supercrazylash/SkidProject/graficos-tabelas-info/tabela-de-preços.MD

| Material | Preço unitário | QTY | Total | Fonte |
| -----: | :----- | :----- | :---- | :---- |
| barras de latão | €2.71 | 2 | €5.42 | https://lingold.pt/chapa-latao/tiras-de-chapa-em-latao-15-mm |
| imanes neodinio | €8.91 | 2 | €17.82 | https://www.supermagnete.pt/screw-on-magnets/block-magnet-80-x-20-x-4mm_CS-Q-80-20-04-N?group=blocks |
| ESC (Controlador BLDC) | €26.90 | 3 | €80.70 | https://entretem.pt/variadores-esc-bec/326-speed-controller-helicopter-30a.html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 |
| Motor DC Sem Escovas (BLDC) | €9.00 | 3 | €27.00 | https://entretem.pt/motores-electricos/15556-motor-brushlessccw2204-2300kv-280mm-un.html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 |
| Bateria LiPo | €15.00 | 1 | €15.00 | https://entretem.pt/baterias/8948-Bateria-lipo-74v-1200mAh.html?search_query=++Bateria+3S&results=769 |
| Relés automóveis | €2.45 | 2 | €4.90 | https://mauser.pt/catalog/product_info.php?products_id=083-0048 |
| N-MOS | €1.72 | 2 | €3.44 | https://mauser.pt/catalog/product_info.php?products_id=002-0729 |
| Giroscopio | €10.48 | 1 | €10.48 | https://www.digikey.pt/en/products/detail/stmicroelectronics/I3G4250DTR/5268011
| Raspberry Pi Compute Module 4 8GB RAM 32GB EMMC | €105.80 | 1 | €105.80 | reaproveitado de outro projeto |
| PCBs várias (estimativa) | N/A | N/A | €35.00 (estimado) | https://aisler.net |
| Miscelanios (cabos, conversores de tensão, pin headers, etc.) | N/A | N/A | €50.00 (estimado) | vários |
| TOTAL | - | - | €355.56 | - |
