supercrazylash/SkidProject/DONTREADME.MD

# TESTE
HEAD
Linhas que estão atoa
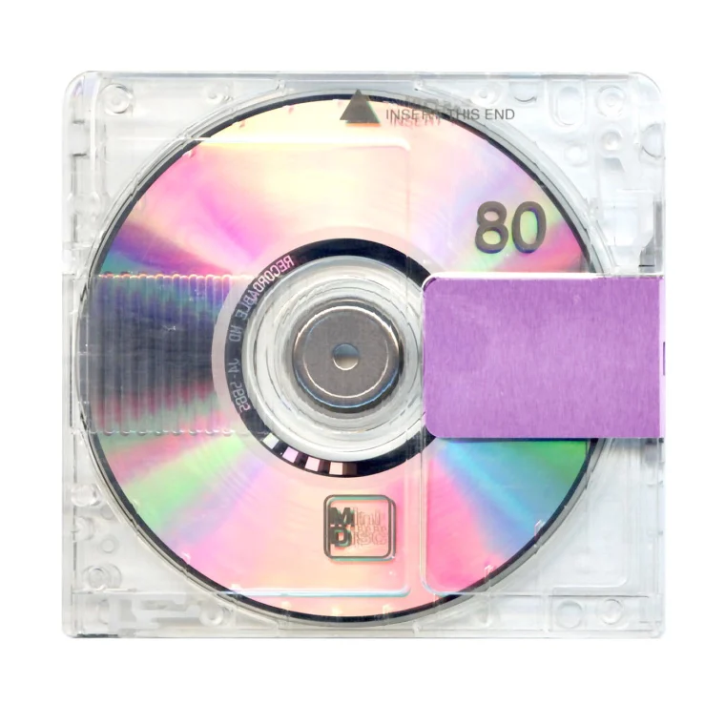
[picture p4: IMG_0239.PNG]
a


a vida é estramha

pila
