supercrazylash/SkidProject/Diagramas de Circuito/Main System/Main System.kicad_pcb

## KiCad design Diagramas de Circuito/Main System/Main System.kicad_pcb (2025-02-24)

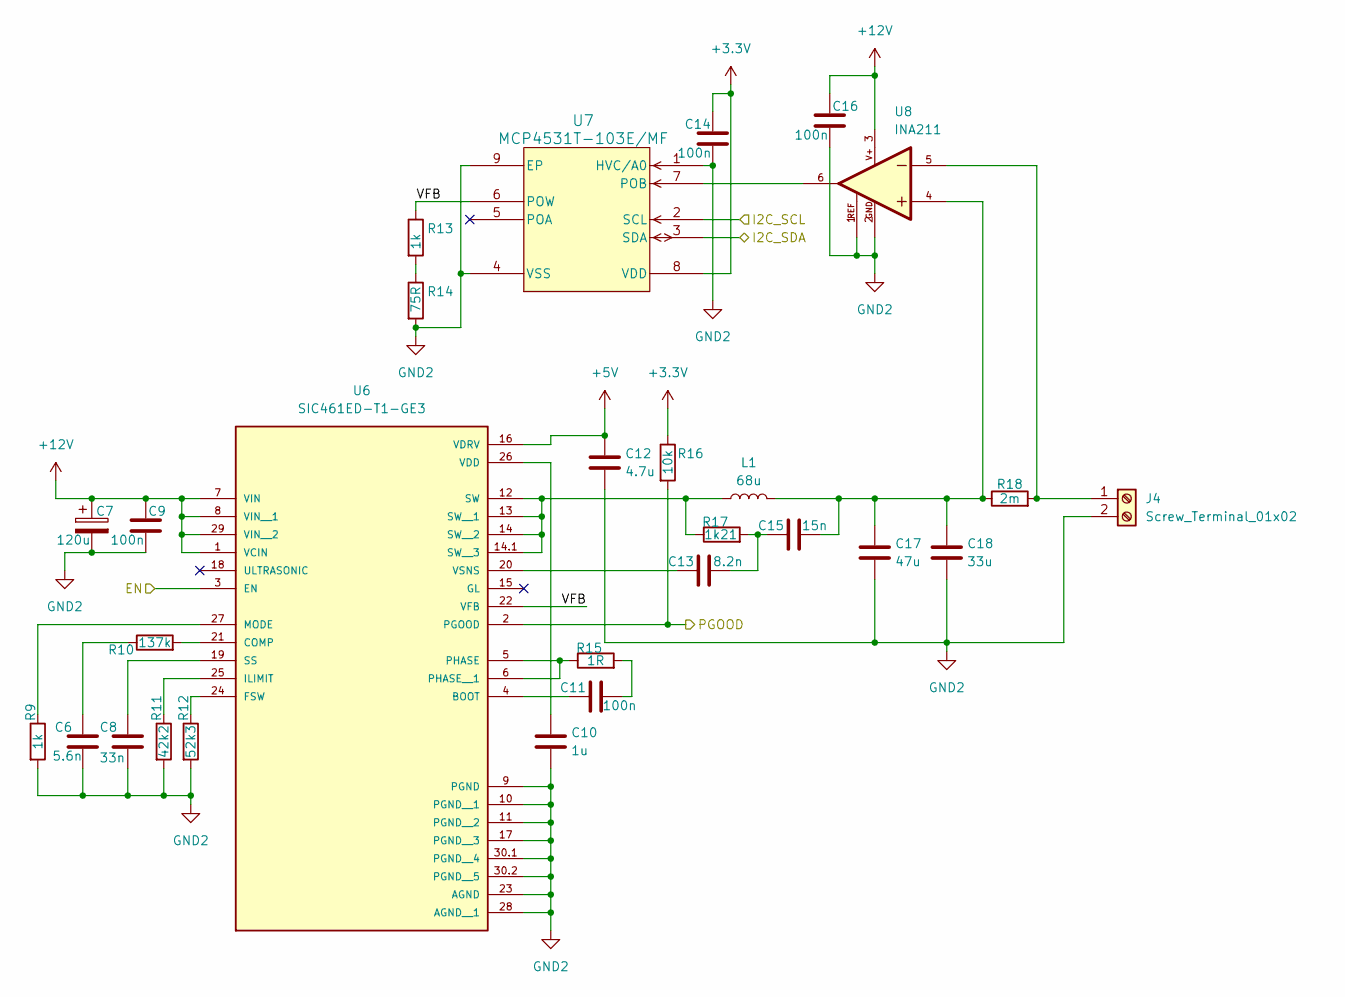
[picture p5: schematic MHD.kicad_sch]

Parts:
C6: 5.6n; C_0402_1005Metric; DIGIKEY_PN 311-3773-1-ND
C7: 120u; CP_Radial_D10.0mm_P5.00mm; DIGIKEY_PN 732-11923-1-ND
C8: 33n; C_0402_1005Metric; DIGIKEY_PN 13-CC0402JRX7R9BB333CT-ND
C9, C11, C14, C16: 100n; C_0603_1608Metric; DIGIKEY_PN 1276-1033-1-ND
C10: 1u; C_0805_2012Metric; DIGIKEY_PN 1276-1029-1-ND
C12: 4.7u; C_0603_1608Metric; DIGIKEY_PN 1276-1784-1-ND
C13: 8.2n; C_0603_1608Metric; DIGIKEY_PN 399-C0603C822K5RACTUCT-ND
C15: 15n; C_0402_1005Metric; DIGIKEY_PN 311-3813-1-ND
C17: 47u; C_1210_3225Metric; DIGIKEY_PN 490-10531-1-ND
C18: 33u; C_1206_3216Metric; DIGIKEY_PN 4713-GMC31X5R336M25NTCT-ND
J4: Screw_Terminal_01x02; TerminalBlock_Phoenix_PT-1,5-2-5.0-H_1x02_P5.00mm_Horizontal; DIGIKEY_PN 277-1667-ND
L1: 68u; L_Pulse_PA4349; DIGIKEY_PN 553-PA4349.683ANLTCT-ND
R9, R13: 1k; R_0402_1005Metric; DIGIKEY_PN P1.0KDCCT-ND
R10: 137k; R_0402_1005Metric; DIGIKEY_PN P137KLCT-ND
R11: 42k2; R_0402_1005Metric; DIGIKEY_PN 311-42.2KLRCT-ND
R12: 52k3; R_0402_1005Metric; DIGIKEY_PN P52.3KLCT-ND
R14: 75R; R_0402_1005Metric; DIGIKEY_PN P75.0LCT-ND
R15: 1R; R_0603_1608Metric; DIGIKEY_PN 311-1.00HRCT-ND
R16: 10k; R_0603_1608Metric; DIGIKEY_PN RMCF0603JT10K0CT-ND
R17: 1k21; R_0402_1005Metric; DIGIKEY_PN P1.21KLCT-ND
R18: 2m; R_2512_6332Metric; DIGIKEY_PN 13-PA2512DKF7W0R002ECT-ND
U6: SIC461ED-T1-GE3; CONV_SIC461ED-T1-GE3; PARTREV M; DIGIKEY_PN SIC461ED-T1-GE3CT-ND
U7: MCP4531T-103E/MF; DFN-8-1EP_3x3mm_P0.5mm_EP1.65x2.38mm; DIGIKEY_PN MCP4531T-103E/MFCT-ND
U8: INA211; SOT-363_SC-70-6; PARTREV J; DIGIKEY_PN 296-41417-1-ND

Connections:
+3.3V: C14.1, R16.1, U7.8 (VDD); also elsewhere on the board
+5V: C12.1, U6.16 (VDRV); also elsewhere on the board
+12V: C7.1, C9.1, C16.1, U6.1 (VCIN), U6.7 (VIN), U6.8 (VIN__1), U6.29 (VIN__2), U8.3; also elsewhere on the board
/Magneto-Hidrodynamic Drive/EN: U6.3 (EN); also elsewhere on the board
/Magneto-Hidrodynamic Drive/PGOOD: R16.2, U6.2 (PGOOD); also elsewhere on the board
/Magneto-Hidrodynamic Drive/VFB: R13.1, U6.22 (VFB), U7.6 (POW)
/Processor/I2C_SCL: U7.2 (SCL); also elsewhere on the board
/Processor/I2C_SDA: U7.3 (SDA); also elsewhere on the board
GND2: C6.2, C7.2, C8.2, C9.2, C10.2, C12.2, C14.2, C16.2, C17.2, C18.2, J4.2, R9.2, R11.2, R12.2, R14.2, U6.9 (PGND), U6.10 (PGND__1), U6.11 (PGND__2), U6.17 (PGND__3), U6.23 (AGND), U6.28 (AGND__1), U6.30.1 (PGND__4), U6.30.2 (PGND__5), U7.1 (HVC/A0), U7.4 (VSS), U7.9 (EP), U8.1, U8.2; also elsewhere on the board
unnamed: C6.1, R10.1
unnamed: C11.2, R15.2
unnamed: C13.2, C15.1, R17.2
unnamed: C15.2, C17.1, C18.1, L1.2, R18.1, U8.4
unnamed: J4.1, R18.2, U8.5
unnamed: R13.2, R14.1
unnamed: C11.1, U6.4 (BOOT)
unnamed: R10.2, U6.21 (COMP)
unnamed: R12.1, U6.24 (FSW)
unnamed: R11.1, U6.25 (ILIMIT)
unnamed: R9.1, U6.27 (MODE)
unnamed: R15.1, U6.5 (PHASE), U6.6 (PHASE__1)
unnamed: C8.1, U6.19 (SS)
unnamed: L1.1, R17.1, U6.12 (SW), U6.13 (SW__1), U6.14 (SW__2), U6.14.1 (SW__3)
unnamed: C10.1, U6.26 (VDD)
unnamed: C13.1, U6.20 (VSNS)
unnamed: U7.7 (POB), U8.6

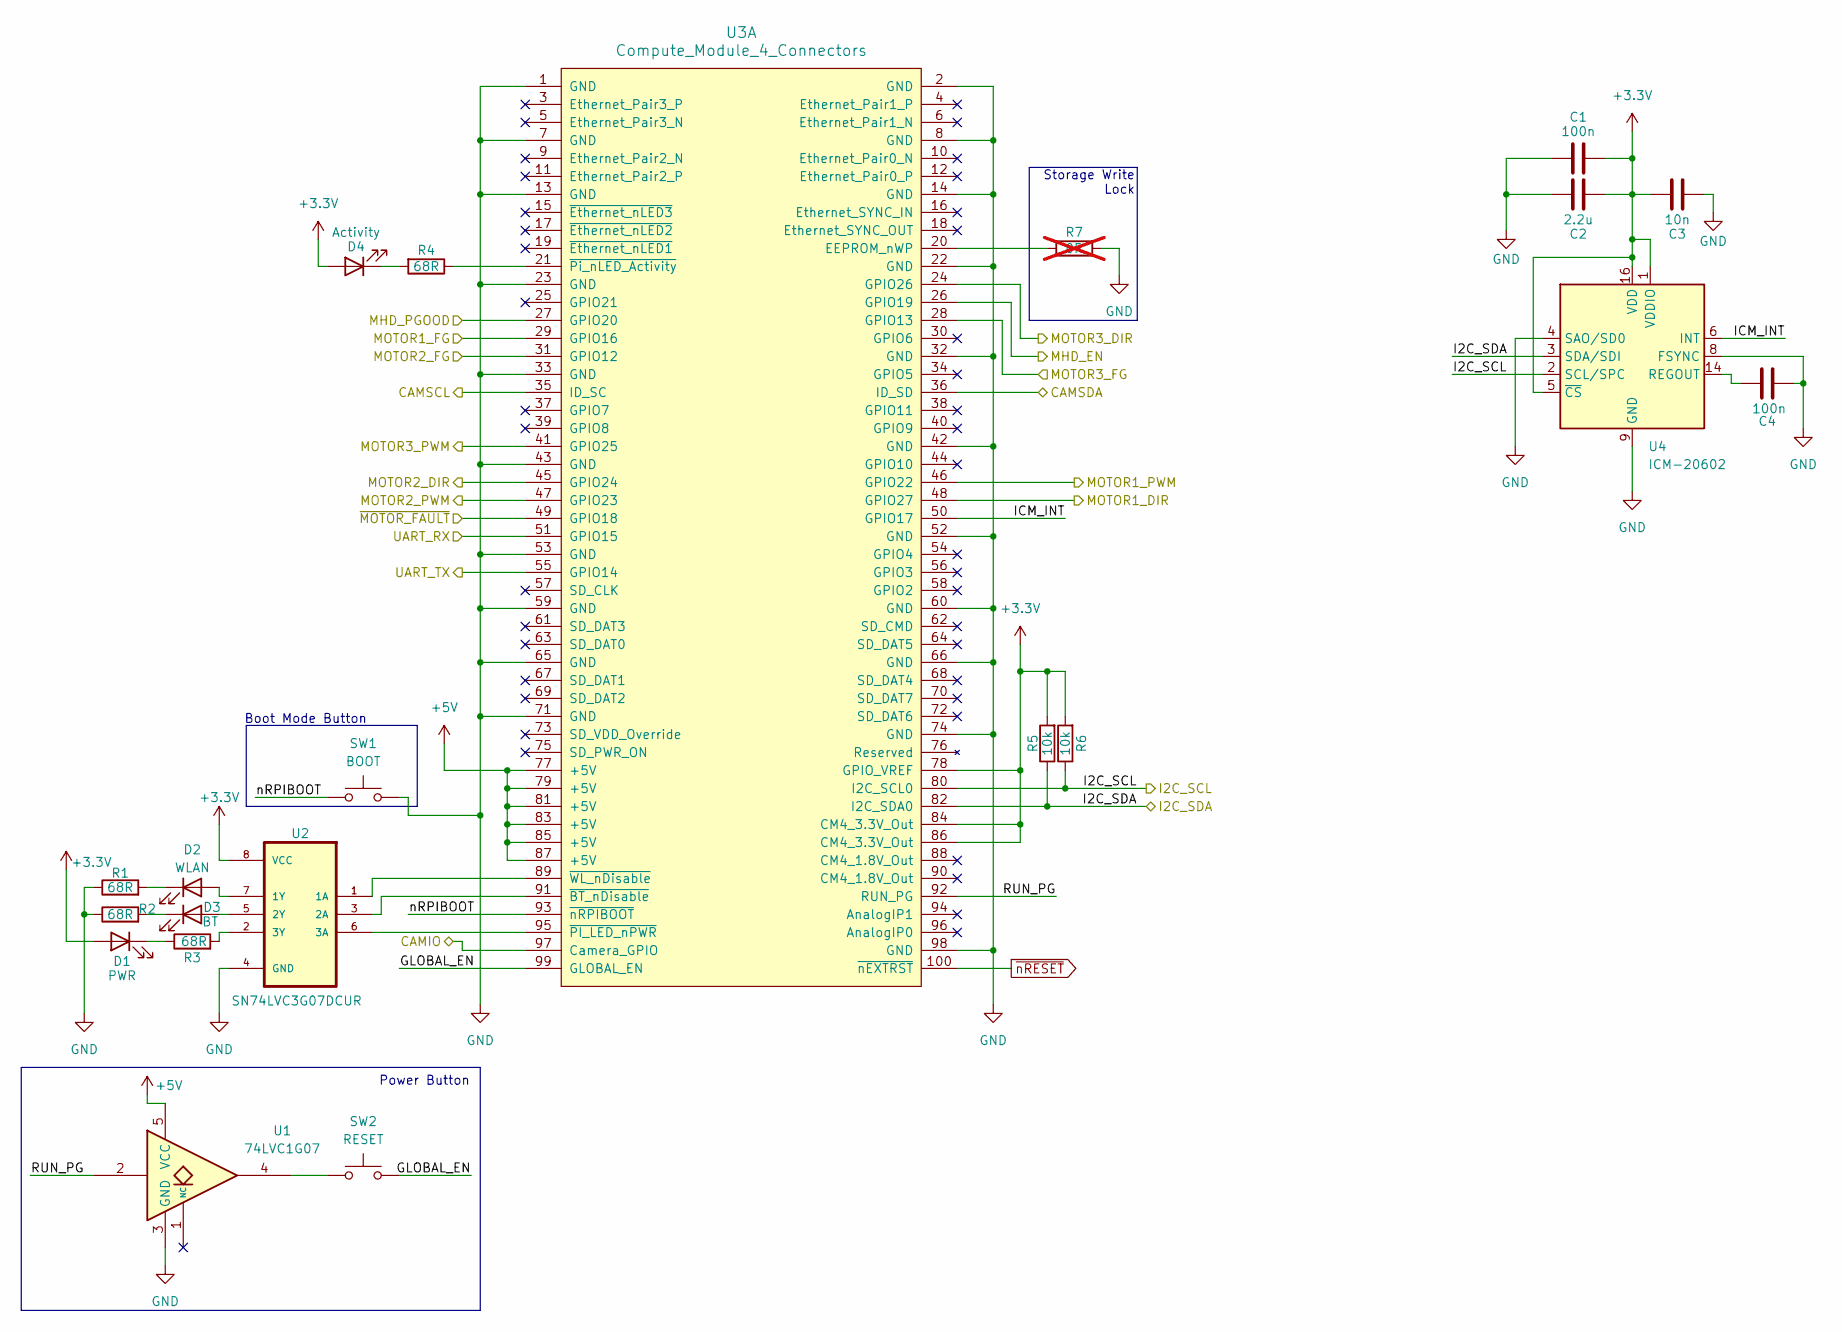
[picture p6: schematic Processor.kicad_sch]

Parts:
C1, C4: 100n; C_0603_1608Metric; DIGIKEY_PN 1276-1033-1-ND
C2: 2.2u; C_0603_1608Metric; DIGIKEY_PN 1276-1040-1-ND
C3: 10n; C_0402_1005Metric; DIGIKEY_PN 1276-1028-1-ND
D1: PWR; LED_0603_1608Metric; DIGIKEY_PN 732-4978-1-ND
D2: WLAN; LED_0603_1608Metric; DIGIKEY_PN 732-4980-1-ND
D3: BT; LED_0603_1608Metric; DIGIKEY_PN 732-4980-1-ND
D4: Activity; LED_0603_1608Metric; DIGIKEY_PN 732-4980-1-ND
R1, R2, R3, R4: 68R; R_0402_1005Metric; DIGIKEY_PN P68.0LCT-ND
R5, R6: 10k; R_0603_1608Metric; DIGIKEY_PN RMCF0603JT10K0CT-ND
R7: 0R; R_0402_1005Metric; DIGIKEY_PN P0.0JCT-ND; not fitted
SW1: BOOT; SW_SPST_PTS647_Sx38; DIGIKEY_PN PTS647SM38SMTR2LFSCT-ND
SW2: RESET; SW_SPST_PTS647_Sx38; DIGIKEY_PN PTS647SM38SMTR2LFSCT-ND
U1: 74LVC1G07; SOT-23-5; DIGIKEY_PN 296-8485-1-ND
U2: SN74LVC3G07DCUR; VSSOP-8_2.3x2mm_P0.5mm; DIGIKEY_PN 296-13283-1-ND
U3: Compute_Module_4_Connectors; Raspberry-Pi-4-Compute-Module; DIGIKEY_PN H11615CT-ND
U4: ICM-20602; LGA-16_3x3mm_P0.5mm_LayoutBorder3x5y; DIGIKEY_PN 1428-1060-1-ND

Connections:
+3.3V: C1.2, C2.2, C3.1, D1.2 (A), D4.2 (A), R5.2, R6.2, U2.8 (VCC), U3.78 (GPIO_VREF), U3.84 (CM4_3.3V_Out), U3.86 (CM4_3.3V_Out), U4.1 (VDDIO), U4.5 (~CS), U4.16 (VDD); also elsewhere on the board
+5V: U1.5 (VCC), U3.77 (+5V), U3.79 (+5V), U3.81 (+5V), U3.83 (+5V), U3.85 (+5V), U3.87 (+5V); also elsewhere on the board
/High Speed IO/CAMIO: U3.97 (Camera_GPIO); also elsewhere on the board
/High Speed IO/CAMSCL: U3.35 (ID_SC); also elsewhere on the board
/High Speed IO/CAMSDA: U3.36 (ID_SD); also elsewhere on the board
/High Speed IO/UART_RX: U3.55 (GPIO14); also elsewhere on the board
/High Speed IO/UART_TX: U3.51 (GPIO15); also elsewhere on the board
/Magneto-Hidrodynamic Drive/EN: U3.26 (GPIO19); also elsewhere on the board
/Magneto-Hidrodynamic Drive/PGOOD: U3.27 (GPIO20); also elsewhere on the board
/Processor/GLOBAL_EN: SW2.2, U3.99 (GLOBAL_EN)
/Processor/I2C_SCL: R6.1, U3.80 (I2C_SCL0), U4.2 (SCL/SPC); also elsewhere on the board
/Processor/I2C_SDA: R5.1, U3.82 (I2C_SDA0), U4.3 (SDA/SDI); also elsewhere on the board
/Processor/ICM_INT: U3.50 (GPIO17), U4.6 (INT)
/Processor/MOTOR1_DIR: U3.48 (GPIO27); also elsewhere on the board
/Processor/MOTOR1_FG: U3.29 (GPIO16); also elsewhere on the board
/Processor/MOTOR1_PWM: U3.46 (GPIO22); also elsewhere on the board
/Processor/MOTOR2_DIR: U3.45 (GPIO24); also elsewhere on the board
/Processor/MOTOR2_FG: U3.31 (GPIO12); also elsewhere on the board
/Processor/MOTOR2_PWM: U3.47 (GPIO23); also elsewhere on the board
/Processor/MOTOR3_DIR: U3.24 (GPIO26); also elsewhere on the board
/Processor/MOTOR3_FG: U3.28 (GPIO13); also elsewhere on the board
/Processor/MOTOR3_PWM: U3.41 (GPIO25); also elsewhere on the board
/Processor/RUN_PG: U1.2, U3.92 (RUN_PG)
/Processor/nRPIBOOT: SW1.1, U3.93 (~nRPIBOOT)
/Processor/~MOTOR_FAULT: U3.49 (GPIO18); also elsewhere on the board
GND: C1.1, C2.1, C3.2, C4.2, R1.1, R2.1, R7.2, SW1.2, U1.3 (GND), U2.4 (GND), U3.1 (GND), U3.2 (GND), U3.7 (GND), U3.8 (GND), U3.13 (GND), U3.14 (GND), U3.22 (GND), U3.23 (GND), U3.32 (GND), U3.33 (GND), U3.42 (GND), U3.43 (GND), U3.52 (GND), U3.53 (GND), U3.59 (GND), U3.60 (GND), U3.65 (GND), U3.66 (GND), U3.71 (GND), U3.74 (GND), U3.98 (GND), U4.4 (SAO/SD0), U4.8 (FSYNC), U4.9 (GND), U4.10 (GND), U4.11 (GND), U4.12 (GND), U4.13 (GND), U4.15 (GND); also elsewhere on the board
unnamed: D1.1 (K), R3.1
unnamed: D2.2 (A), U2.7 (1Y)
unnamed: D2.1 (K), R1.2
unnamed: D3.2 (A), U2.5 (2Y)
unnamed: D3.1 (K), R2.2
unnamed: D4.1 (K), R4.2
unnamed: SW2.1, U1.4
unnamed: U2.1 (1A), U3.89 (~WL_nDisable)
unnamed: U2.3 (2A), U3.91 (~BT_nDisable)
unnamed: U2.6 (3A), U3.95 (~PI_LED_nPWR)
unnamed: R3.2, U2.2 (3Y)
unnamed: R7.1, U3.20 (EEPROM_nWP)
unnamed: R4.1, U3.21 (~Pi_nLED_Activity)
unnamed: C4.1, U4.14 (REGOUT)
~nRESET: U3.100 (~nEXTRST); also elsewhere on the board

Notes on the sheet:
Storage Write Lock
Power Button
Boot Mode Button

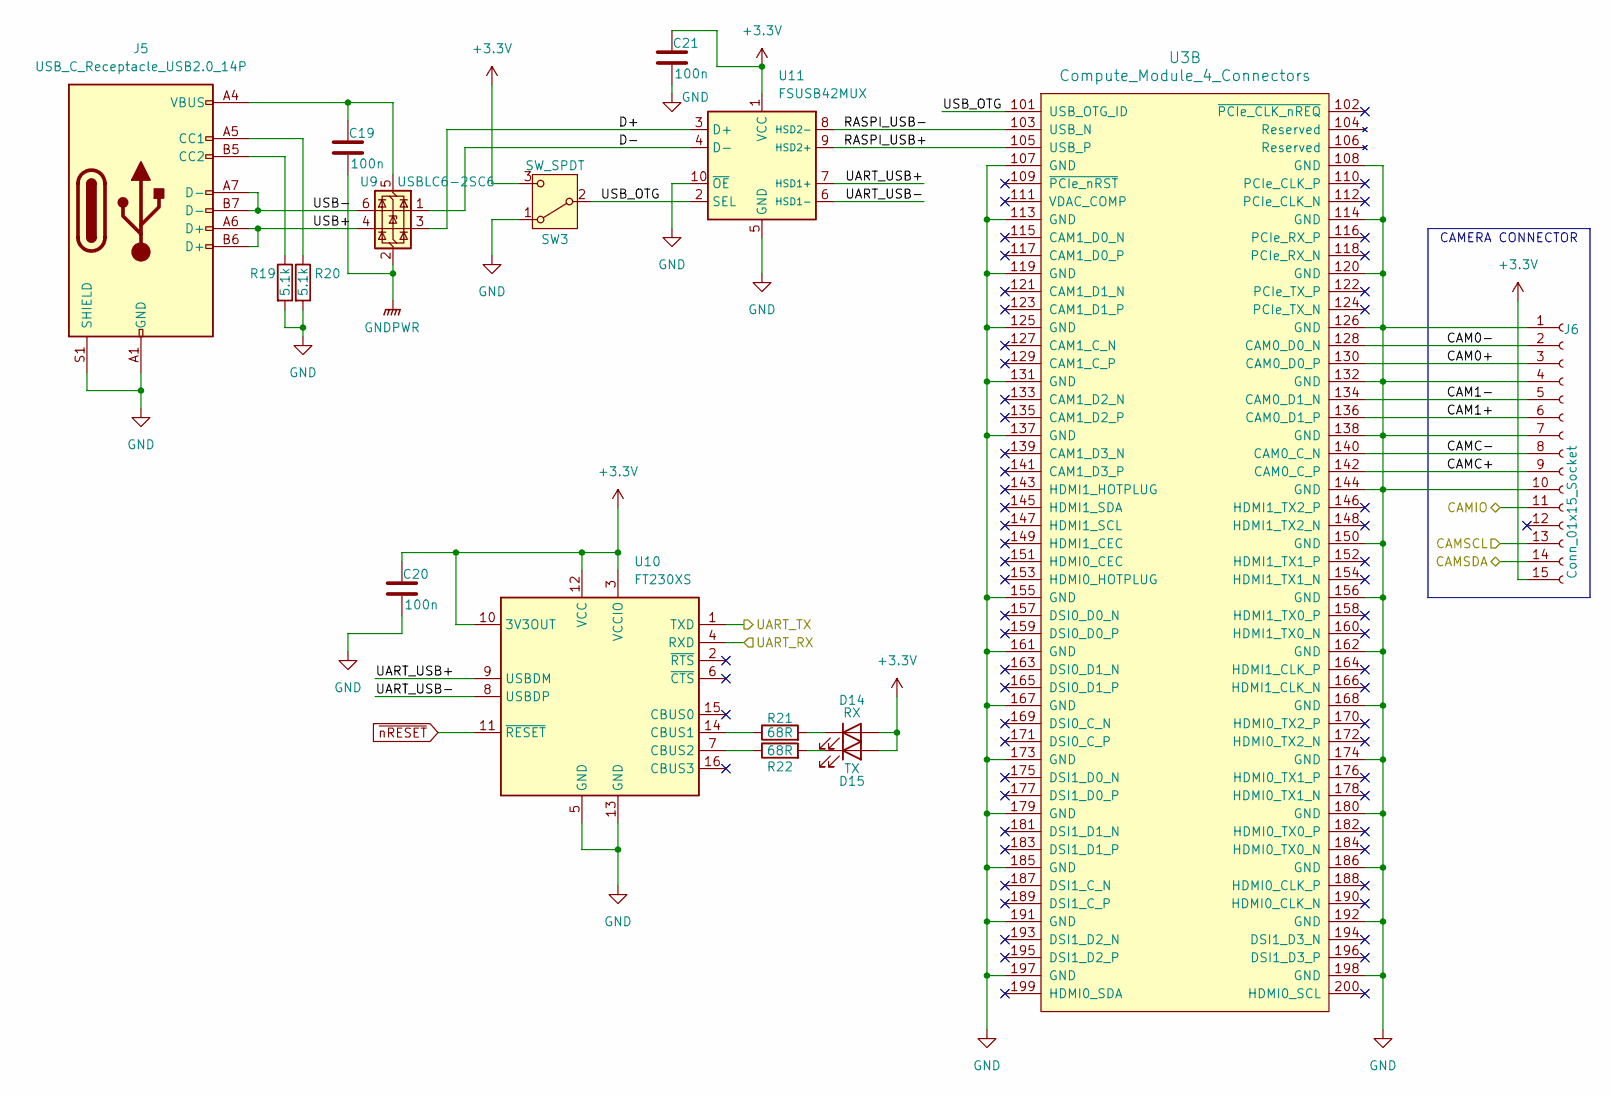
[picture p7: schematic HSIO.kicad_sch]

Parts:
C19, C20, C21: 100n; C_0603_1608Metric; DIGIKEY_PN 1276-1033-1-ND
D14: RX; LED_0603_1608Metric; DIGIKEY_PN 732-4980-1-ND
D15: TX; LED_0603_1608Metric; DIGIKEY_PN 732-4980-1-ND
J5: USB_C_Receptacle_USB2.0_14P; USB4120-03-C_GCT; DIGIKEY_PN 2073-USB4120-03-CCT-ND
J6: Conn_01x15_Socket; GCT_FFC3A20-15-G_REVA1; DIGIKEY_PN 2073-FFC3A20-15-GCT-ND
R19, R20: 5.1k; R_0402_1005Metric; DIGIKEY_PN P5.10KLCT-ND
R21, R22: 68R; R_0402_1005Metric; DIGIKEY_PN P68.0LCT-ND
SW3: SW_SPDT; SW_JS102011JCQN; DIGIKEY_PN CKN10721CT-ND
U3: Compute_Module_4_Connectors; Raspberry-Pi-4-Compute-Module; DIGIKEY_PN H11615CT-ND
U9: USBLC6-2SC6; SOT-23-6; DIGIKEY_PN 497-5235-1-ND
U10: FT230XS; SSOP-16_3.9x4.9mm_P0.635mm; DIGIKEY_PN 768-1135-1-ND
U11: FSUSB42MUX; MSOP-10_3x3mm_P0.5mm; DIGIKEY_PN FSUSB42MUXCT-ND

Connections:
+3.3V: C20.1, C21.1, D14.2 (A), D15.2 (A), J6.15, SW3.3 (C), U10.3 (VCCIO), U10.10 (3V3OUT), U10.12 (VCC), U11.1 (VCC); also elsewhere on the board
/High Speed IO/CAM0+: J6.3, U3.130 (CAM0_D0_P)
/High Speed IO/CAM0-: J6.2, U3.128 (CAM0_D0_N)
/High Speed IO/CAM1+: J6.6, U3.136 (CAM0_D1_P)
/High Speed IO/CAM1-: J6.5, U3.134 (CAM0_D1_N)
/High Speed IO/CAMC+: J6.9, U3.142 (CAM0_C_P)
/High Speed IO/CAMC-: J6.8, U3.140 (CAM0_C_N)
/High Speed IO/CAMIO: J6.11; also elsewhere on the board
/High Speed IO/CAMSCL: J6.13; also elsewhere on the board
/High Speed IO/CAMSDA: J6.14; also elsewhere on the board
/High Speed IO/D+: U9.3 (I/O2), U11.3 (D+)
/High Speed IO/D-: U9.1 (I/O1), U11.4 (D-)
/High Speed IO/RASPI_USB+: U3.105 (USB_P), U11.9 (HSD2+)
/High Speed IO/RASPI_USB-: U3.103 (USB_N), U11.8 (HSD2-)
/High Speed IO/UART_RX: U10.4 (RXD); also elsewhere on the board
/High Speed IO/UART_TX: U10.1 (TXD); also elsewhere on the board
/High Speed IO/UART_USB+: U10.9 (USBDM), U11.7 (HSD1+)
/High Speed IO/UART_USB-: U10.8 (USBDP), U11.6 (HSD1-)
/High Speed IO/USB+: J5.A6 (D+), J5.B6 (D+), U9.4 (I/O2)
/High Speed IO/USB-: J5.A7 (D-), J5.B7 (D-), U9.6 (I/O1)
/High Speed IO/USB_OTG: SW3.2 (B), U3.101 (USB_OTG_ID), U11.2 (SEL)
GND: C20.2, C21.2, J5.A1 (GND), J5.A12 (GND), J5.B1 (GND), J5.B12 (GND), J5.S1 (SHIELD), J6.1, J6.4, J6.7, J6.10, R19.2, R20.2, SW3.1 (A), U3.107 (GND), U3.108 (GND), U3.113 (GND), U3.114 (GND), U3.119 (GND), U3.120 (GND), U3.125 (GND), U3.126 (GND), U3.131 (GND), U3.132 (GND), U3.137 (GND), U3.138 (GND), U3.144 (GND), U3.150 (GND), U3.155 (GND), U3.156 (GND), U3.161 (GND), U3.162 (GND), U3.167 (GND), U3.168 (GND), U3.173 (GND), U3.174 (GND), U3.179 (GND), U3.180 (GND), U3.185 (GND), U3.186 (GND), U3.191 (GND), U3.192 (GND), U3.197 (GND), U3.198 (GND), U10.5 (GND), U10.13 (GND), U11.5 (GND), U11.10 (~OE); also elsewhere on the board
GNDPWR: C19.2, U9.2 (GND); also elsewhere on the board
unnamed: D14.1 (K), R21.2
unnamed: D15.1 (K), R22.2
unnamed: J5.A5 (CC1), R20.1
unnamed: J5.B5 (CC2), R19.1
unnamed: C19.1, J5.A4 (VBUS), J5.A9 (VBUS), J5.B4 (VBUS), J5.B9 (VBUS), U9.5 (VBUS)
unnamed: R21.1, U10.14 (CBUS1)
unnamed: R22.1, U10.7 (CBUS2)
~nRESET: U10.11 (~RESET); also elsewhere on the board

Notes on the sheet:
CAMERA CONNECTOR

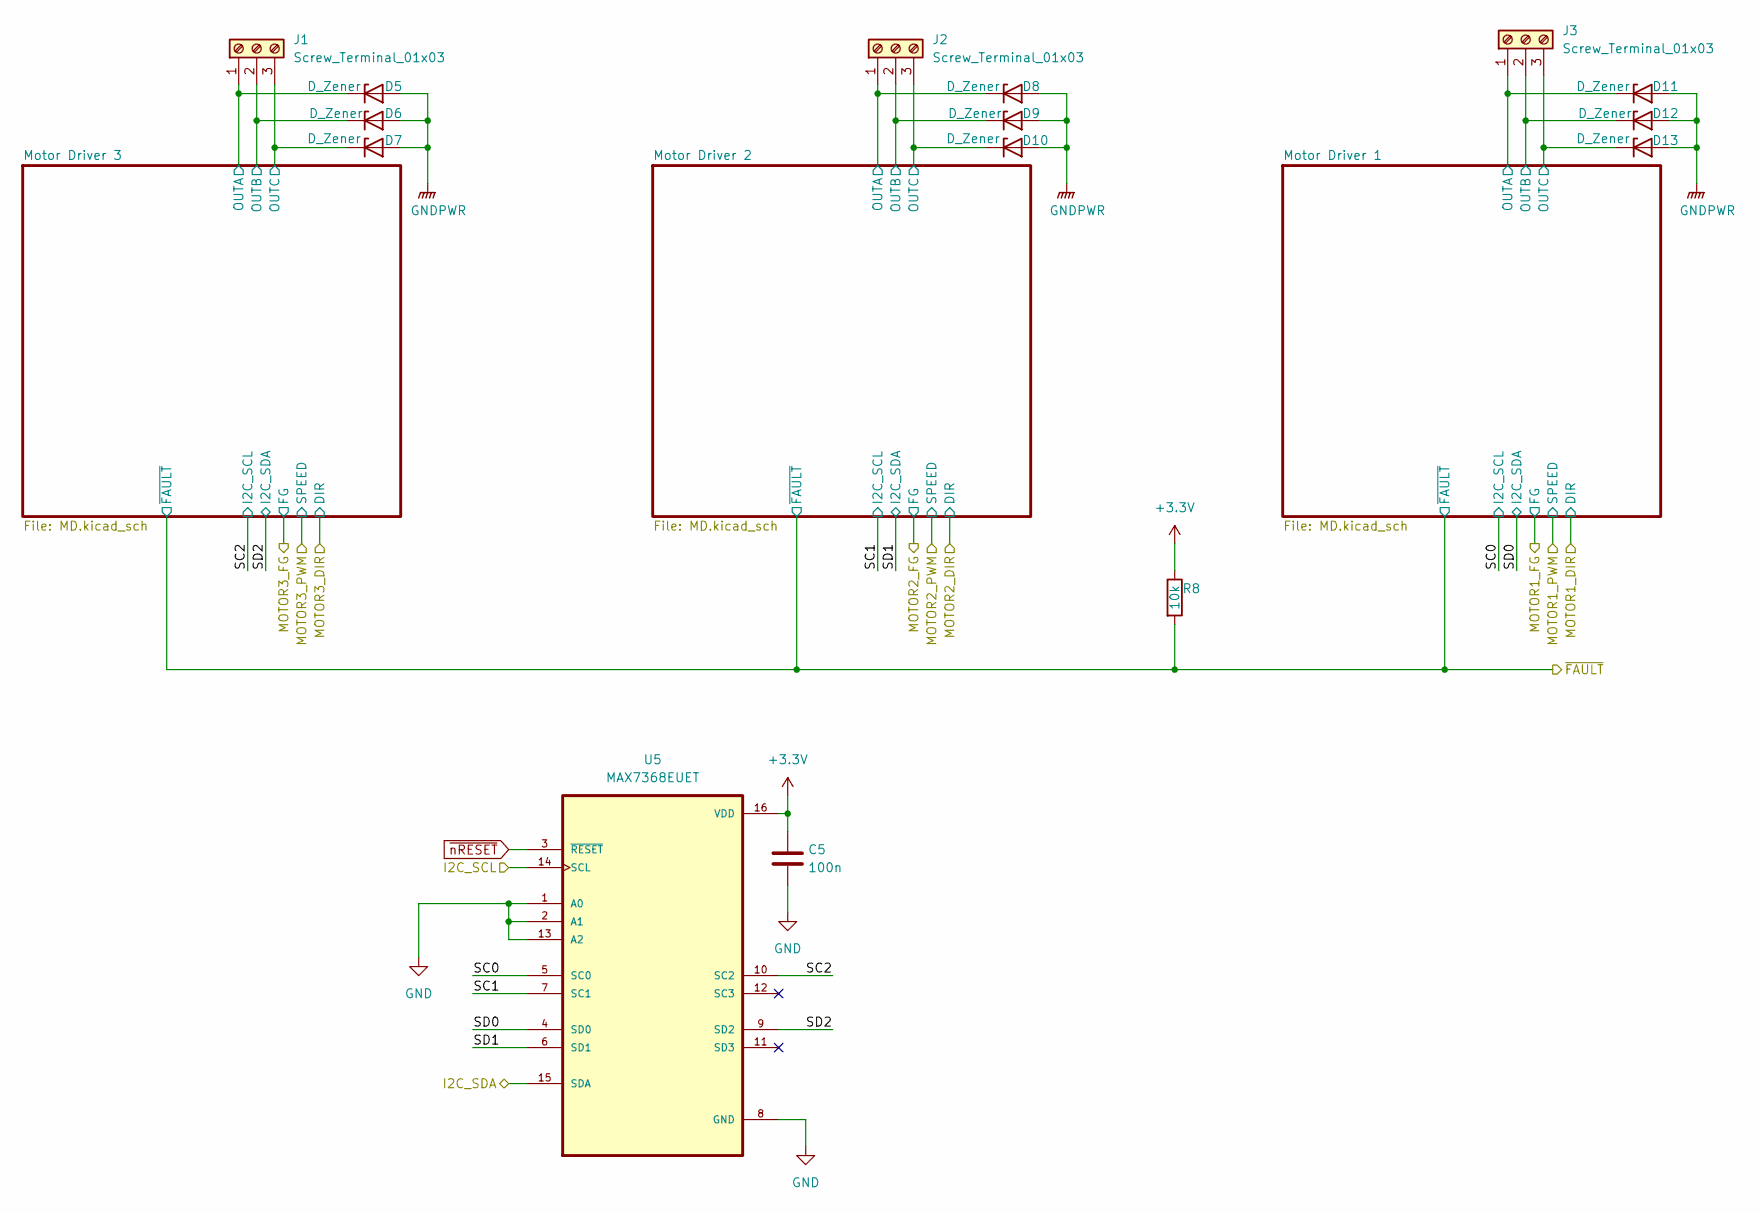
[picture p8: schematic reaction_wheels.kicad_sch]

Parts:
C5: 100n; C_0603_1608Metric; DIGIKEY_PN 1276-1033-1-ND
D5, D6, D7, D8, D9, D10, D11, D12, D13: D_Zener; D_SMB; DIGIKEY_PN SMBJ10A-FDICT-ND
J1, J2, J3: Screw_Terminal_01x03; TerminalBlock_Phoenix_PT-1,5-3-5.0-H_1x03_P5.00mm_Horizontal; DIGIKEY_PN 277-1578-ND
R8: 10k; R_0603_1608Metric; DIGIKEY_PN RMCF0603JT10K0CT-ND
U5: MAX7368EUET; TSSOP-16_4.4x5mm_P0.65mm; DIGIKEY_PN MAX7368EUE+-ND

Connections:
+3.3V: C5.1, R8.1, U5.16 (VDD); also elsewhere on the board
/Processor/I2C_SCL: U5.14 (SCL); also elsewhere on the board
/Processor/I2C_SDA: U5.15 (SDA); also elsewhere on the board
/Processor/~MOTOR_FAULT: R8.2; also elsewhere on the board
/Reaction Wheels/Motor Driver 1/OUTA: D11.1 (K), J3.1; also elsewhere on the board
/Reaction Wheels/Motor Driver 1/OUTB: D12.1 (K), J3.2; also elsewhere on the board
/Reaction Wheels/Motor Driver 1/OUTC: D13.1 (K), J3.3; also elsewhere on the board
/Reaction Wheels/Motor Driver 2/OUTA: D8.1 (K), J2.1; also elsewhere on the board
/Reaction Wheels/Motor Driver 2/OUTB: D9.1 (K), J2.2; also elsewhere on the board
/Reaction Wheels/Motor Driver 2/OUTC: D10.1 (K), J2.3; also elsewhere on the board
/Reaction Wheels/Motor Driver 3/OUTA: D5.1 (K), J1.1; also elsewhere on the board
/Reaction Wheels/Motor Driver 3/OUTB: D6.1 (K), J1.2; also elsewhere on the board
/Reaction Wheels/Motor Driver 3/OUTC: D7.1 (K), J1.3; also elsewhere on the board
/Reaction Wheels/SC0: U5.5 (SC0); also elsewhere on the board
/Reaction Wheels/SC1: U5.7 (SC1); also elsewhere on the board
/Reaction Wheels/SC2: U5.10 (SC2); also elsewhere on the board
/Reaction Wheels/SD0: U5.4 (SD0); also elsewhere on the board
/Reaction Wheels/SD1: U5.6 (SD1); also elsewhere on the board
/Reaction Wheels/SD2: U5.9 (SD2); also elsewhere on the board
GND: C5.2, U5.1 (A0), U5.2 (A1), U5.8 (GND), U5.13 (A2); also elsewhere on the board
GNDPWR: D5.2 (A), D6.2 (A), D7.2 (A), D8.2 (A), D9.2 (A), D10.2 (A), D11.2 (A), D12.2 (A), D13.2 (A); also elsewhere on the board
~nRESET: U5.3 (~RESET); also elsewhere on the board

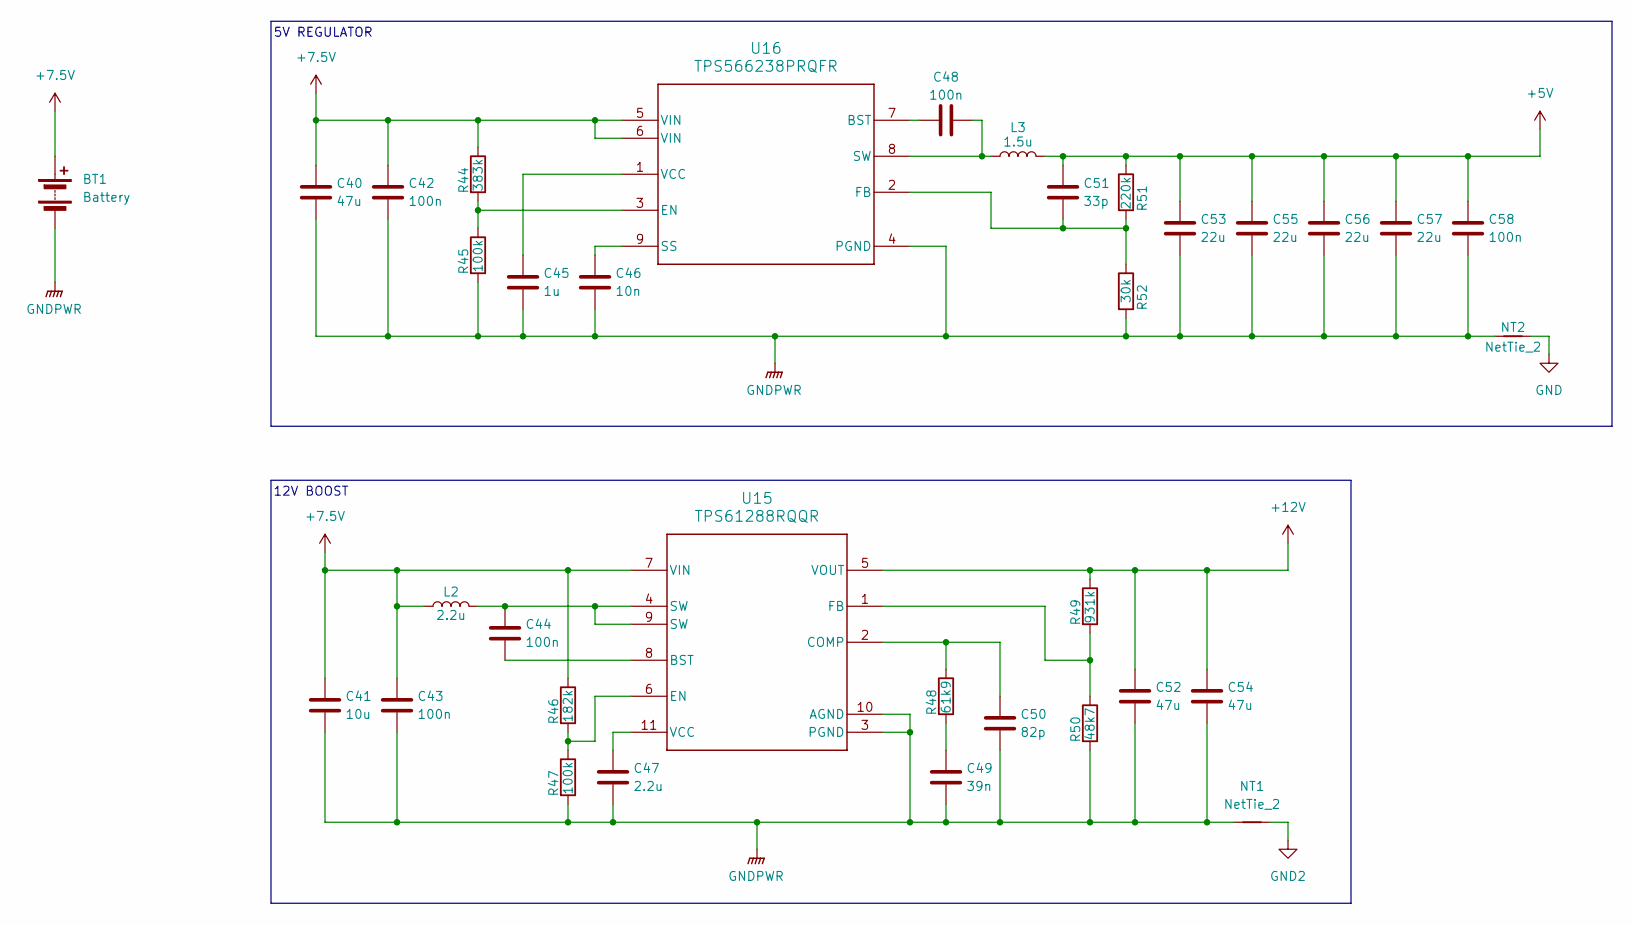
[picture p9: schematic psup.kicad_sch]

Parts:
BT1: Battery; DEANS; DIGIKEY_PN 1568-1659-ND
C40, C52, C54: 47u; C_1210_3225Metric; DIGIKEY_PN 490-10531-1-ND
C41: 10u; C_0805_2012Metric; DIGIKEY_PN 1276-6455-1-ND
C42, C43, C44, C48, C58: 100n; C_0603_1608Metric; DIGIKEY_PN 1276-1033-1-ND
C45: 1u; C_0805_2012Metric; DIGIKEY_PN 1276-1029-1-ND
C46: 10n; C_0402_1005Metric; DIGIKEY_PN 1276-1028-1-ND
C47: 2.2u; C_0603_1608Metric; DIGIKEY_PN 1276-1040-1-ND
C49: 39n; C_0603_1608Metric; DIGIKEY_PN 1276-2055-1-ND
C50: 82p; C_0402_1005Metric; DIGIKEY_PN 311-1023-1-ND
C51: 33p; C_0402_1005Metric; DIGIKEY_PN 1276-1272-1-ND
C53, C55, C56, C57: 22u; C_1206_3216Metric; DIGIKEY_PN 1276-3047-1-ND
L2: 2.2u; IND_IHLP-5050CE-01_VIS; DIGIKEY_PN 541-1019-1-ND
L3: 1.5u; IND_-1R5MC_SUM; DIGIKEY_PN 308-2497-1-ND
NT1, NT2: NetTie_2; NetTie-2_SMD_Pad2.0mm
R44: 383k; R_0402_1005Metric; DIGIKEY_PN P383KLCT-ND
R45, R47: 100k; R_0603_1608Metric; DIGIKEY_PN P100KHCT-ND
R46: 182k; R_0402_1005Metric; DIGIKEY_PN P182KLCT-ND
R48: 61k9; R_0402_1005Metric; DIGIKEY_PN P61.9KLCT-ND
R49: 931k; R_0402_1005Metric; DIGIKEY_PN P931KLCT-ND
R50: 48k7; R_0402_1005Metric; DIGIKEY_PN P48.7KLCT-ND
R51: 220k; R_0402_1005Metric; DIGIKEY_PN P220KLCT-ND
R52: 30k; R_0402_1005Metric; DIGIKEY_PN P30.0KLCT-ND
U15: TPS61288RQQR; RQQ0011A-MFG; DIGIKEY_PN 296-TPS61288RQQRCT-ND
U16: TPS566238PRQFR; RQF0009A; DIGIKEY_PN 296-TPS566238PRQFRCT-ND

Connections:
+5V: C51.1, C53.1, C55.1, C56.1, C57.1, C58.1, L3.2, R51.1; also elsewhere on the board
+7.5V: BT1.1 (+), C40.1, C41.1, C42.1, C43.1, L2.1, R44.1, R46.1, U15.7 (VIN), U16.5 (VIN), U16.6 (VIN); also elsewhere on the board
+12V: C52.1, C54.1, R49.1, U15.5 (VOUT); also elsewhere on the board
GND: NT2.2; also elsewhere on the board
GND2: NT1.2; also elsewhere on the board
GNDPWR: BT1.2 (-), C40.2, C41.2, C42.2, C43.2, C45.2, C46.2, C47.2, C49.2, C50.2, C52.2, C53.2, C54.2, C55.2, C56.2, C57.2, C58.2, NT1.1, NT2.1, R45.2, R47.2, R50.2, R52.2, U15.3 (PGND), U15.10 (AGND), U16.4 (PGND); also elsewhere on the board
unnamed: C44.1, L2.2, U15.4 (SW), U15.9 (SW)
unnamed: C49.1, R48.2
unnamed: C44.2, U15.8 (BST)
unnamed: C50.1, R48.1, U15.2 (COMP)
unnamed: R46.2, R47.1, U15.6 (EN)
unnamed: R49.2, R50.1, U15.1 (FB)
unnamed: C47.1, U15.11 (VCC)
unnamed: C48.1, U16.7 (BST)
unnamed: R44.2, R45.1, U16.3 (EN)
unnamed: C51.2, R51.2, R52.1, U16.2 (FB)
unnamed: C46.1, U16.9 (SS)
unnamed: C48.2, L3.1, U16.8 (SW)
unnamed: C45.1, U16.1 (VCC)

Notes on the sheet:
5V REGULATOR
12V BOOST

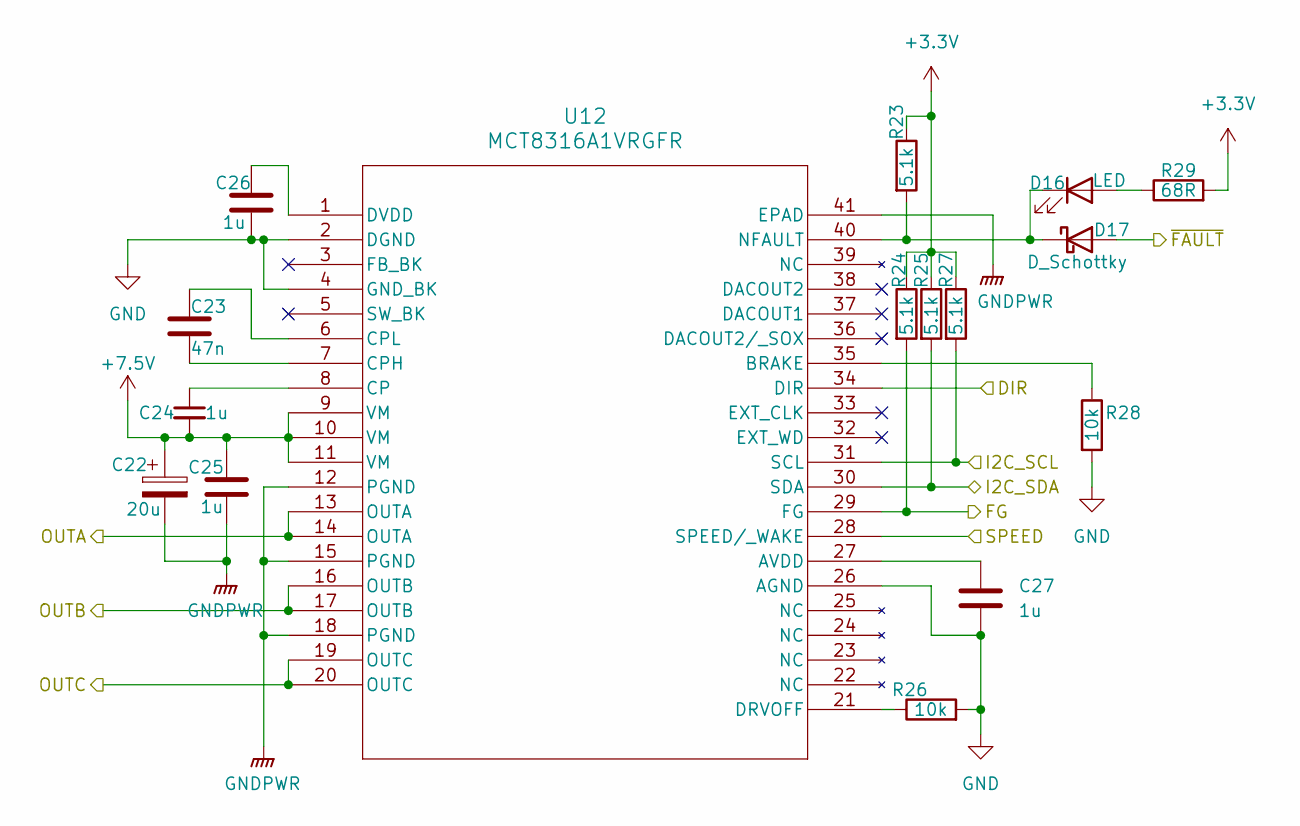
[picture p10: schematic MD.kicad_sch]

Parts:
C22: 20u; CP_Radial_D10.0mm_P5.00mm; DIGIKEY_PN 565-EGXF351ELL200MJ25S-ND
C23: 47n; C_0402_1005Metric; DIGIKEY_PN 445-6897-1-ND
C24, C25, C26, C27: 1u; C_0805_2012Metric; DIGIKEY_PN 1276-1029-1-ND
D16: LED; LED_0603_1608Metric; DIGIKEY_PN 732-4978-1-ND
D17: D_Schottky; D_SOD-323; DIGIKEY_PN 3757-SD103AWS_R1_00001CT-ND
R23, R24, R25, R27: 5.1k; R_0402_1005Metric; DIGIKEY_PN P5.10KLCT-ND
R26, R28: 10k; R_0603_1608Metric; DIGIKEY_PN RMCF0603JT10K0CT-ND
R29: 68R; R_0402_1005Metric; DIGIKEY_PN P68.0LCT-ND
U12: MCT8316A1VRGFR; VQFN40_RGF_TEX; DIGIKEY_PN 296-MCT8316A1VRGFRCT-ND

Connections:
+3.3V: R23.1, R24.1, R25.1, R27.1, R29.2; also elsewhere on the board
+7.5V: C22.1, C24.2, C25.1, U12.9 (VM), U12.10 (VM), U12.11 (VM); also elsewhere on the board
/Processor/MOTOR1_DIR: U12.34 (DIR); also elsewhere on the board
/Processor/MOTOR1_FG: R24.2, U12.29 (FG); also elsewhere on the board
/Processor/MOTOR1_PWM: U12.28 (SPEED/_WAKE); also elsewhere on the board
/Processor/~MOTOR_FAULT: D17.2 (A); also elsewhere on the board
/Reaction Wheels/Motor Driver 1/OUTA: U12.13 (OUTA), U12.14 (OUTA); also elsewhere on the board
/Reaction Wheels/Motor Driver 1/OUTB: U12.16 (OUTB), U12.17 (OUTB); also elsewhere on the board
/Reaction Wheels/Motor Driver 1/OUTC: U12.19 (OUTC), U12.20 (OUTC); also elsewhere on the board
/Reaction Wheels/SC0: R27.2, U12.31 (SCL); also elsewhere on the board
/Reaction Wheels/SD0: R25.2, U12.30 (SDA); also elsewhere on the board
GND: C26.2, C27.2, R26.2, R28.2, U12.2 (DGND), U12.4 (GND_BK), U12.26 (AGND); also elsewhere on the board
GNDPWR: C22.2, C25.2, U12.12 (PGND), U12.15 (PGND), U12.18 (PGND), U12.41 (EPAD); also elsewhere on the board
unnamed: D16.2 (A), R29.1
unnamed: D16.1 (K), D17.1 (K), R23.2, U12.40 (NFAULT)
unnamed: C27.1, U12.27 (AVDD)
unnamed: R28.1, U12.35 (BRAKE)
unnamed: C24.1, U12.8 (CP)
unnamed: C23.2, U12.7 (CPH)
unnamed: C23.1, U12.6 (CPL)
unnamed: R26.1, U12.21 (DRVOFF)
unnamed: C26.1, U12.1 (DVDD)

Parts of its further copies:
C28, C34: 20u; CP_Radial_D10.0mm_P5.00mm; DIGIKEY_PN 565-EGXF351ELL200MJ25S-ND
C29, C35: 47n; C_0402_1005Metric; DIGIKEY_PN 445-6897-1-ND
C30, C31, C32, C33, C36, C37, C38, C39: 1u; C_0805_2012Metric; DIGIKEY_PN 1276-1029-1-ND
D18, D20: LED; LED_0603_1608Metric; DIGIKEY_PN 732-4978-1-ND
D19, D21: D_Schottky; D_SOD-323; DIGIKEY_PN 3757-SD103AWS_R1_00001CT-ND
R30, R31, R32, R34, R37, R38, R39, R41: 5.1k; R_0402_1005Metric; DIGIKEY_PN P5.10KLCT-ND
R33, R35, R40, R42: 10k; R_0603_1608Metric; DIGIKEY_PN RMCF0603JT10K0CT-ND
R36, R43: 68R; R_0402_1005Metric; DIGIKEY_PN P68.0LCT-ND
U13, U14: MCT8316A1VRGFR; VQFN40_RGF_TEX; DIGIKEY_PN 296-MCT8316A1VRGFRCT-ND

Connections of its further copies:
+3.3V: R30.1, R31.1, R32.1, R34.1, R36.2, R37.1, R38.1, R39.1, R41.1, R43.2; also elsewhere on the board
+7.5V: C28.1, C30.2, C31.1, C34.1, C36.2, C37.1, U13.9 (VM), U13.10 (VM), U13.11 (VM), U14.9 (VM), U14.10 (VM), U14.11 (VM); also elsewhere on the board
/Processor/MOTOR2_DIR: U13.34 (DIR); also elsewhere on the board
/Processor/MOTOR2_FG: R31.2, U13.29 (FG); also elsewhere on the board
/Processor/MOTOR2_PWM: U13.28 (SPEED/_WAKE); also elsewhere on the board
/Processor/MOTOR3_DIR: U14.34 (DIR); also elsewhere on the board
/Processor/MOTOR3_FG: R38.2, U14.29 (FG); also elsewhere on the board
/Processor/MOTOR3_PWM: U14.28 (SPEED/_WAKE); also elsewhere on the board
/Processor/~MOTOR_FAULT: D19.2 (A), D21.2 (A); also elsewhere on the board
/Reaction Wheels/Motor Driver 2/OUTA: U13.13 (OUTA), U13.14 (OUTA); also elsewhere on the board
/Reaction Wheels/Motor Driver 2/OUTB: U13.16 (OUTB), U13.17 (OUTB); also elsewhere on the board
/Reaction Wheels/Motor Driver 2/OUTC: U13.19 (OUTC), U13.20 (OUTC); also elsewhere on the board
/Reaction Wheels/Motor Driver 3/OUTA: U14.13 (OUTA), U14.14 (OUTA); also elsewhere on the board
/Reaction Wheels/Motor Driver 3/OUTB: U14.16 (OUTB), U14.17 (OUTB); also elsewhere on the board
/Reaction Wheels/Motor Driver 3/OUTC: U14.19 (OUTC), U14.20 (OUTC); also elsewhere on the board
/Reaction Wheels/SC1: R34.2, U13.31 (SCL); also elsewhere on the board
/Reaction Wheels/SC2: R41.2, U14.31 (SCL); also elsewhere on the board
/Reaction Wheels/SD1: R32.2, U13.30 (SDA); also elsewhere on the board
/Reaction Wheels/SD2: R39.2, U14.30 (SDA); also elsewhere on the board
GND: C32.2, C33.2, C38.2, C39.2, R33.2, R35.2, R40.2, R42.2, U13.2 (DGND), U13.4 (GND_BK), U13.26 (AGND), U14.2 (DGND), U14.4 (GND_BK), U14.26 (AGND); also elsewhere on the board
GNDPWR: C28.2, C31.2, C34.2, C37.2, U13.12 (PGND), U13.15 (PGND), U13.18 (PGND), U13.41 (EPAD), U14.12 (PGND), U14.15 (PGND), U14.18 (PGND), U14.41 (EPAD); also elsewhere on the board
unnamed: D18.2 (A), R36.1
unnamed: D18.1 (K), D19.1 (K), R30.2, U13.40 (NFAULT)
unnamed: D20.2 (A), R43.1
unnamed: D20.1 (K), D21.1 (K), R37.2, U14.40 (NFAULT)
unnamed: C33.1, U13.27 (AVDD)
unnamed: R35.1, U13.35 (BRAKE)
unnamed: C30.1, U13.8 (CP)
unnamed: C29.2, U13.7 (CPH)
unnamed: C29.1, U13.6 (CPL)
unnamed: R33.1, U13.21 (DRVOFF)
unnamed: C32.1, U13.1 (DVDD)
unnamed: C39.1, U14.27 (AVDD)
unnamed: R42.1, U14.35 (BRAKE)
unnamed: C36.1, U14.8 (CP)
unnamed: C35.2, U14.7 (CPH)
unnamed: C35.1, U14.6 (CPL)
unnamed: R40.1, U14.21 (DRVOFF)
unnamed: C38.1, U14.1 (DVDD)
