supercrazylash/SkidProject/Diagramas de Circuito/Main System/Main System.kicad_pcb

## KiCad design Diagramas de Circuito/Main System/Main System.kicad_pcb (continued)

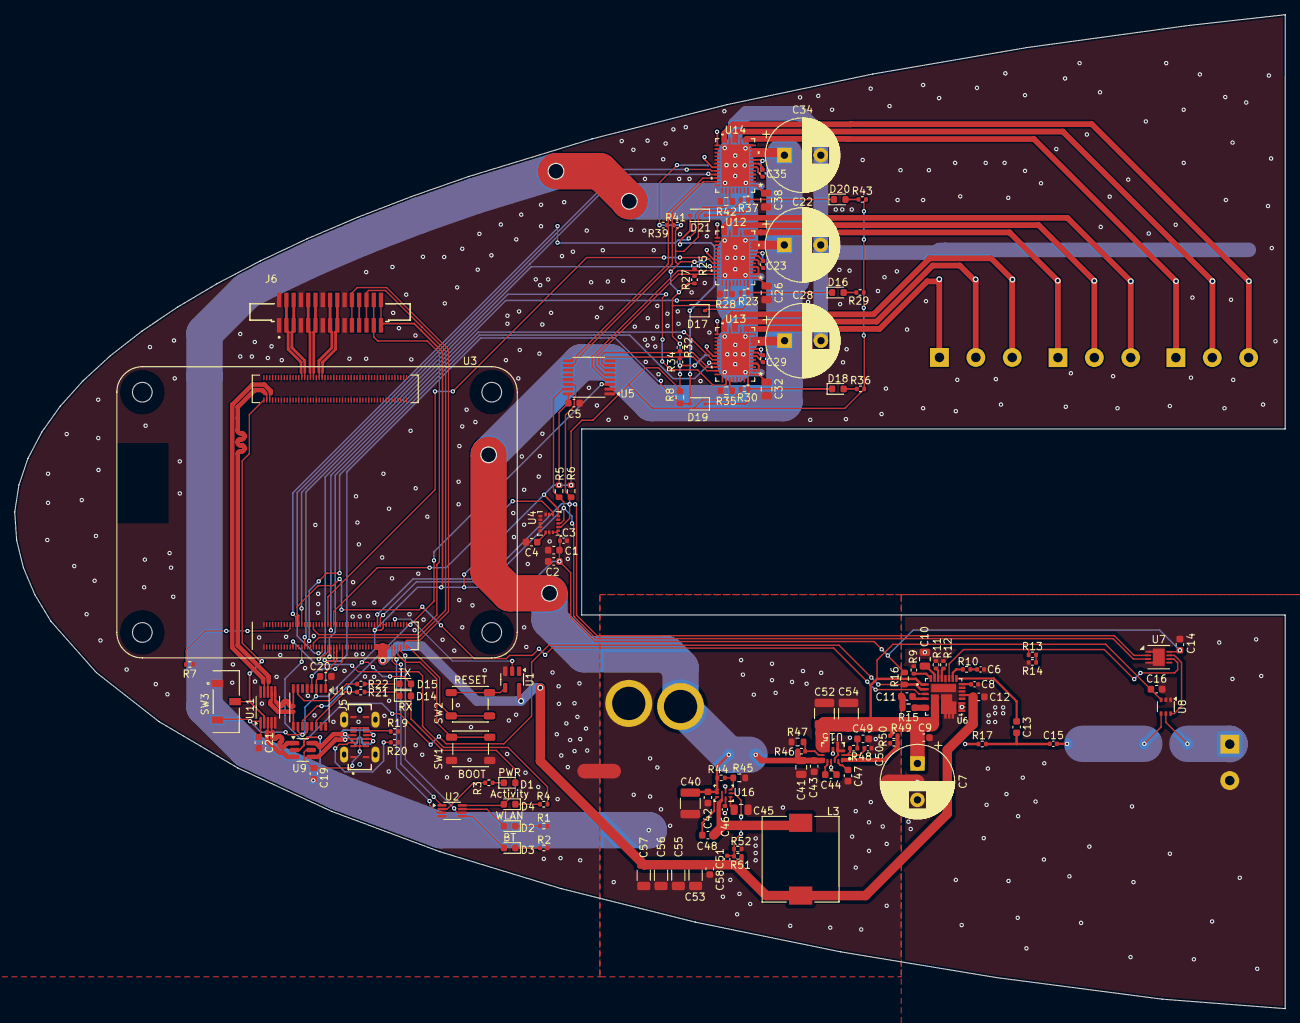
[picture p11: board Main System.kicad_pcb from above]

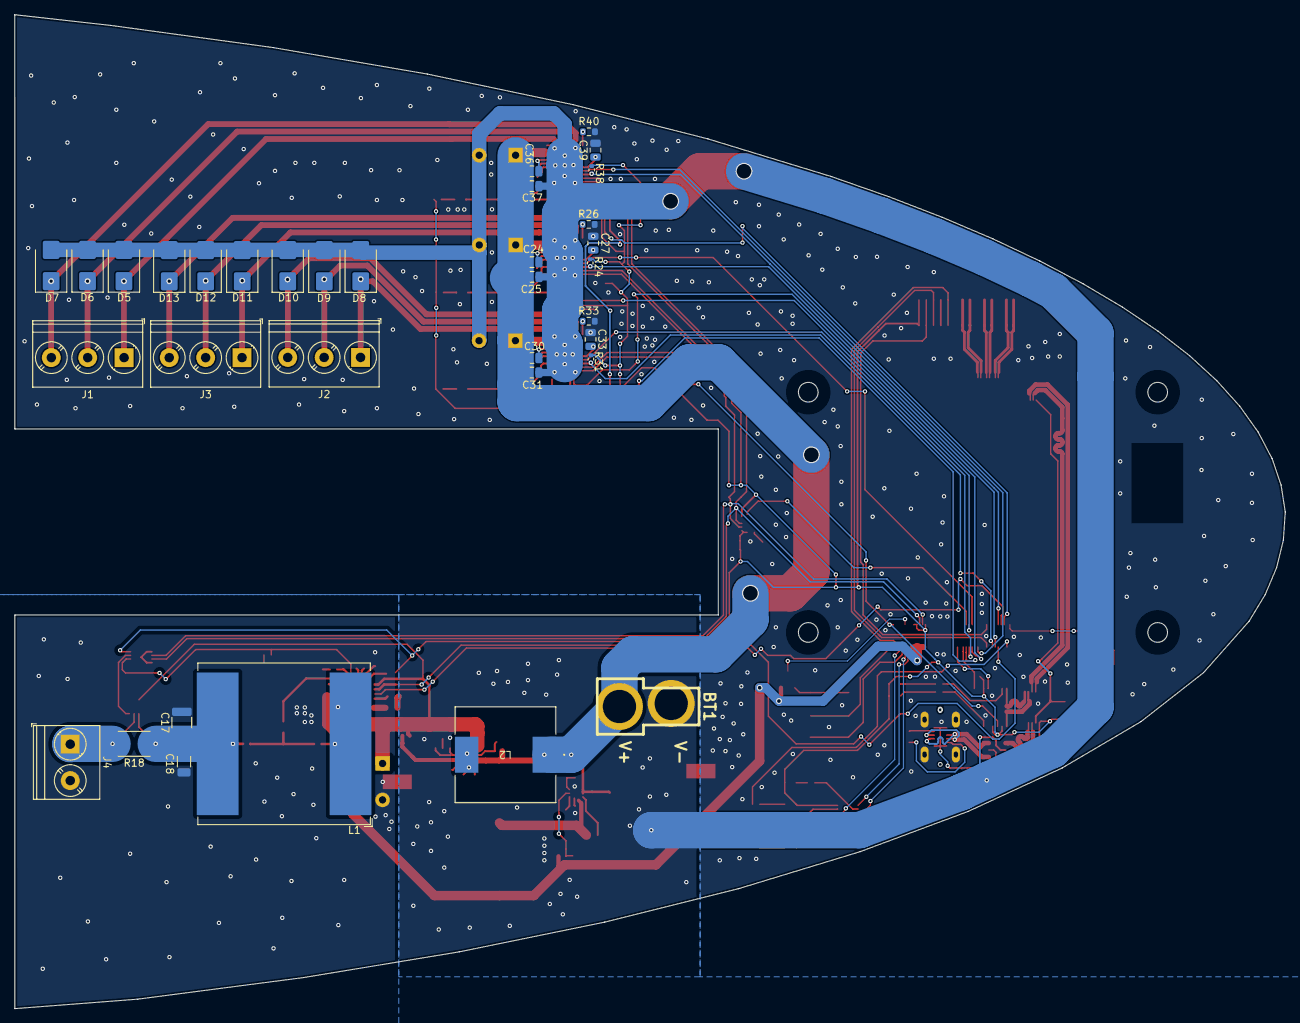
[picture p12: board Main System.kicad_pcb from below]

Board: 2 copper layers, 174.5 x 136.5 mm, 162 parts (34 on the bottom side), 140 nets.
