supercrazylash/SkidProject/(commit log)

2024-11-14 paulinho bola de ouro
2024-11-22 report start
    [BLDC Control.kicad_pcb, BLDC Control.kicad_sch]
